fluxly/Fluxamasynth-Designs/_FluxamasynthFeather/FLUXAMASYNTHFeatherSilk.pdf

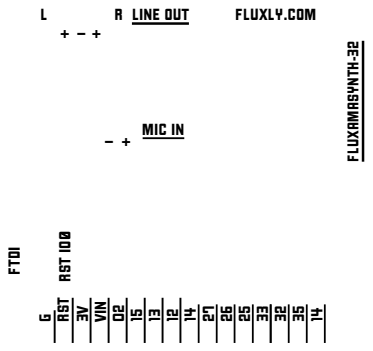
[picture p1: figure]
RST; VIN; RST IO0; FTDI; – + MIC IN; LINE OUTRL; FLUXAMASYNTH-32; FLUXLY.COM
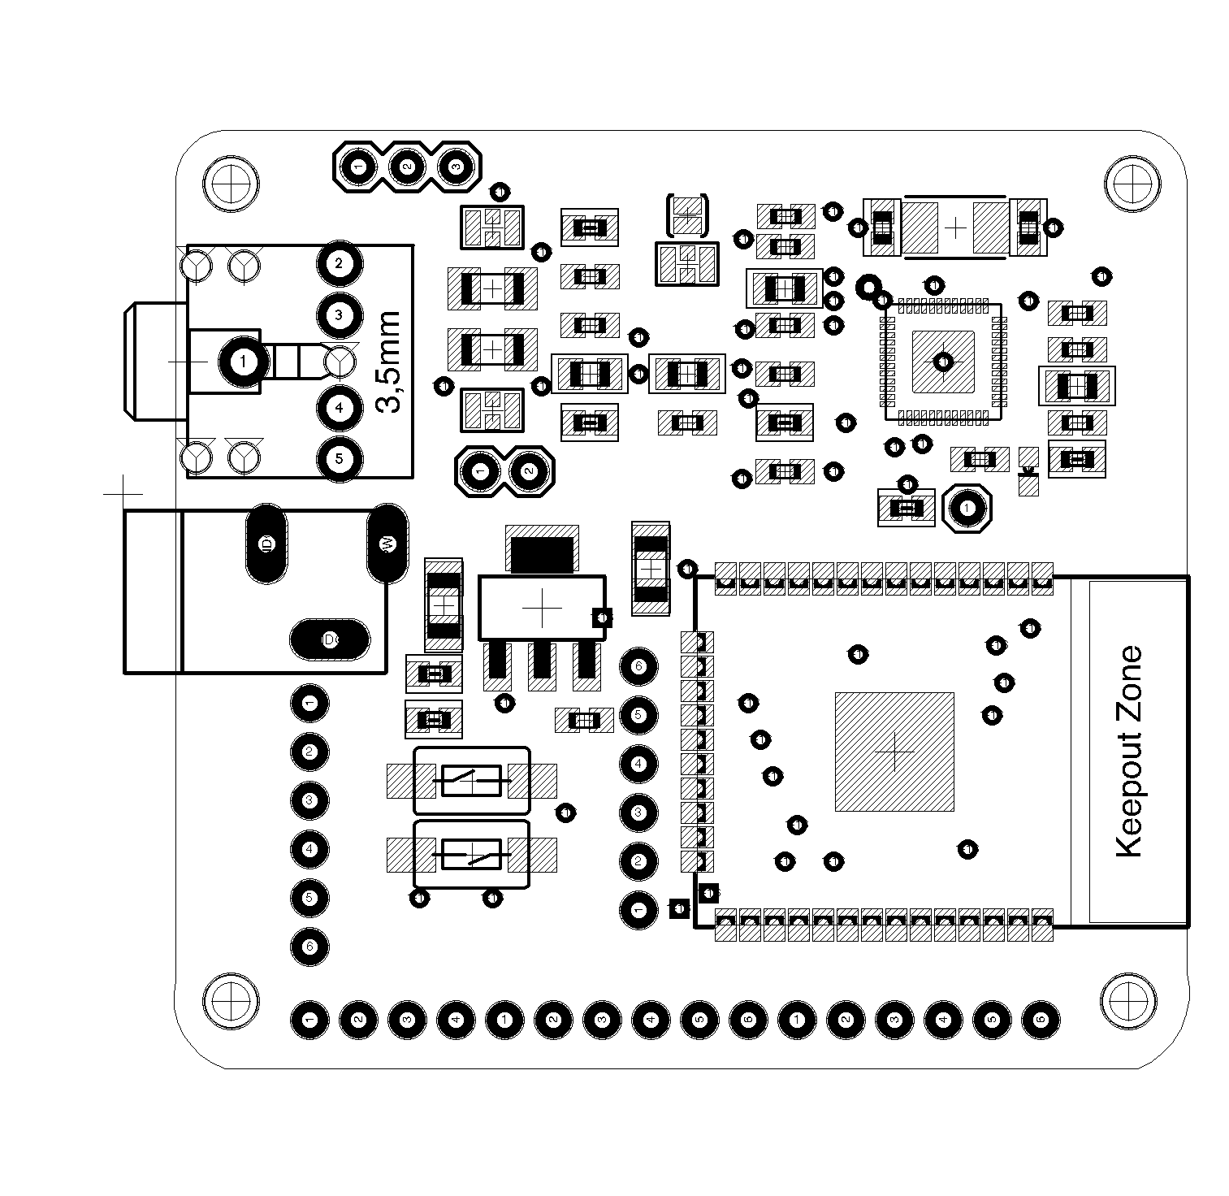
[picture p2: figure]
