fluxly/Fluxamasynth-Designs/_Fluxamasynth32/Artwork/FLUXYNTHbOTTOMsILK.bmp

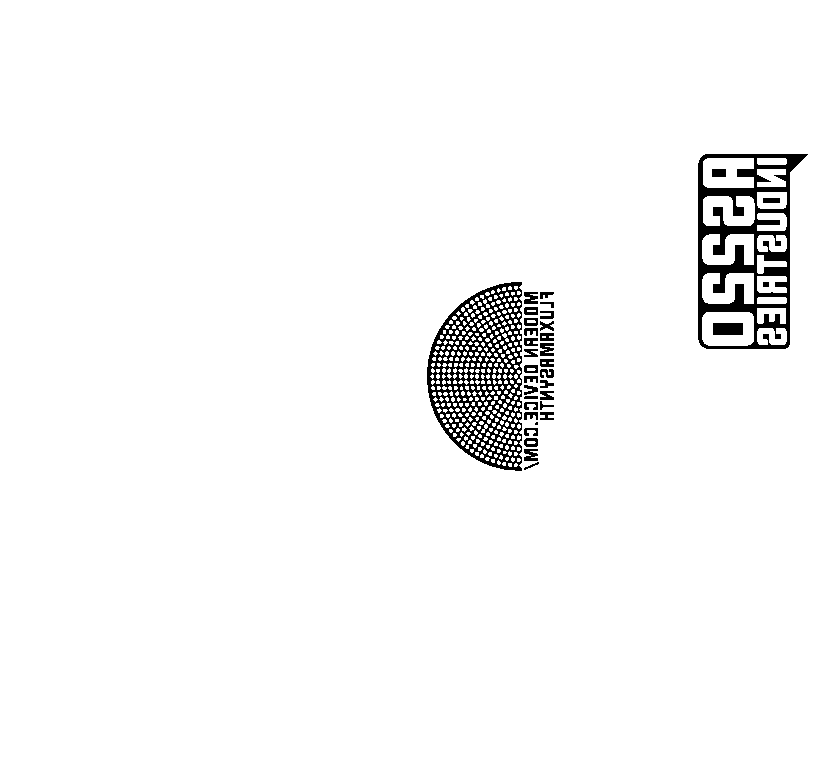
_Fluxamasynth32/Artwork/FLUXYNTHbOTTOMsILK.bmp
