fluxly/Fluxamasynth-Designs/_Fluxamasynth32/Artwork/fs32Stencil.png

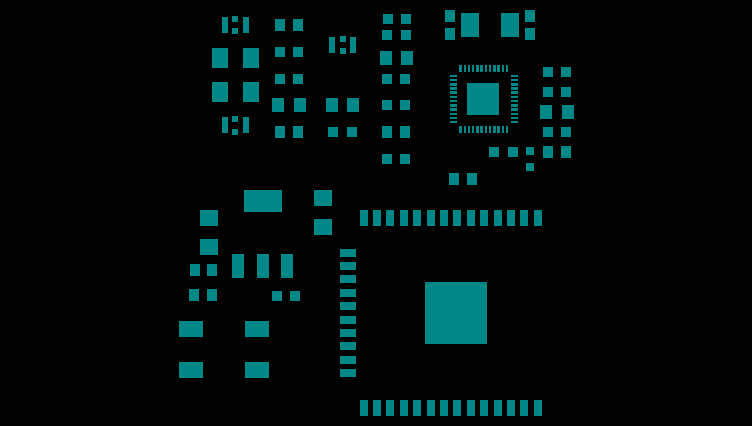
_Fluxamasynth32/Artwork/fs32Stencil.png
