fluxly/Fluxamasynth-Designs/_Fluxamasynth32/bottom.png

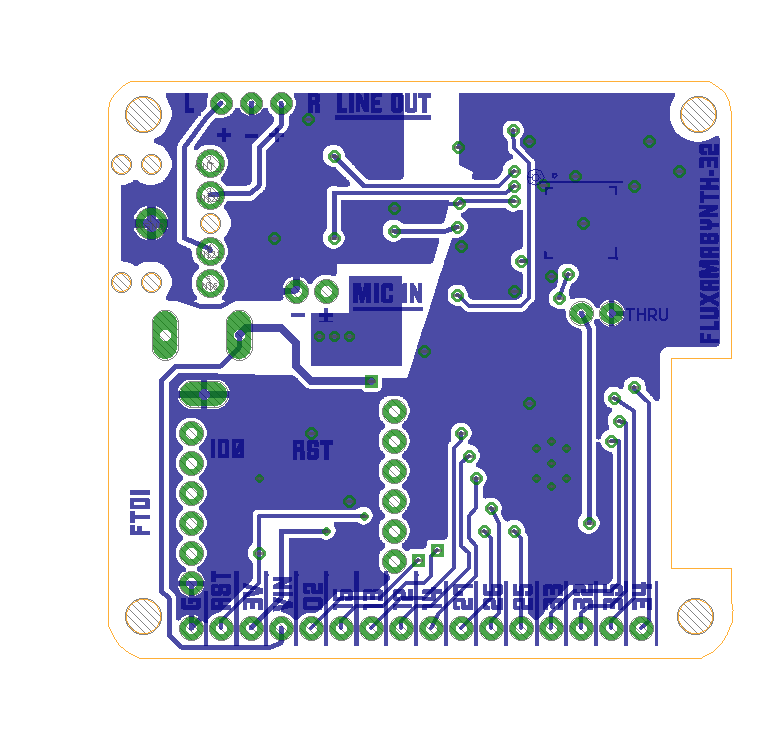
_Fluxamasynth32/bottom.png
