fluxly/Fluxamasynth-Designs/_FluxamasynthFeather/Artwork/fsFeatherStencil.png

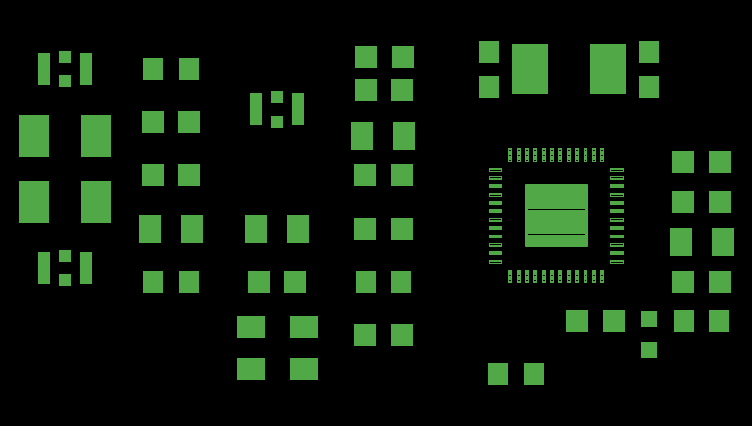
_FluxamasynthFeather/Artwork/fsFeatherStencil.png
