fluxly/Fluxamasynth-Designs/_FluxamasynthFeather/FSFeatherLayout.png

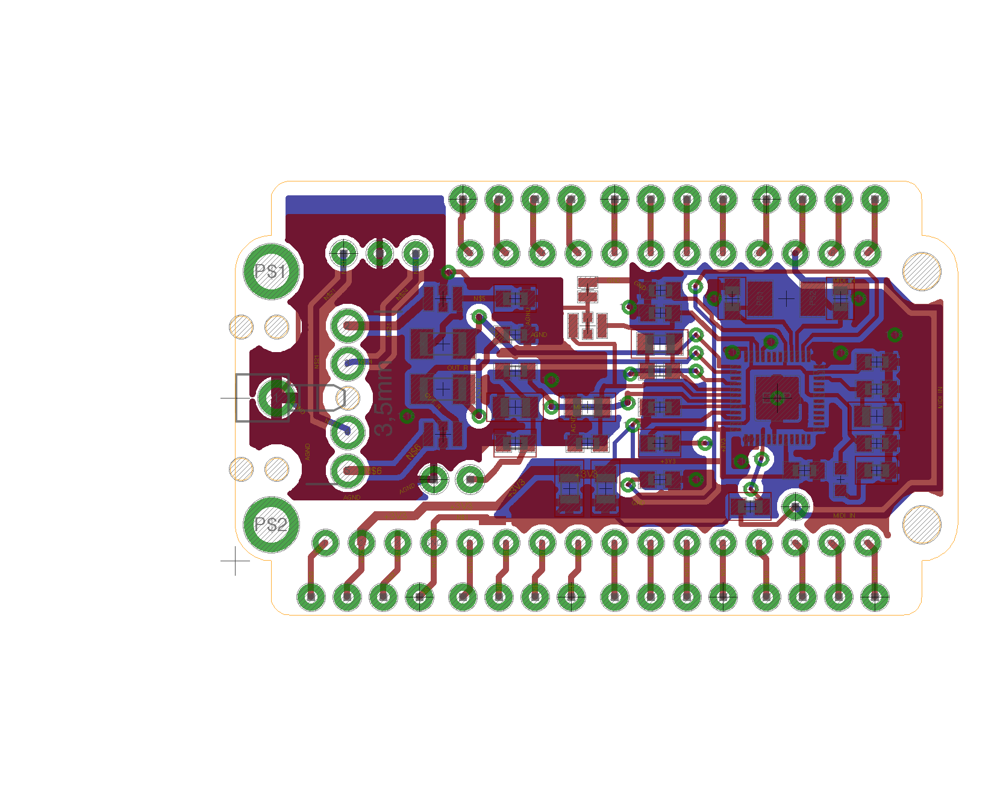
_FluxamasynthFeather/FSFeatherLayout.png
