fluxly/Fluxamasynth-Designs/_FluxamasynthFeather/fsSilk.bmp

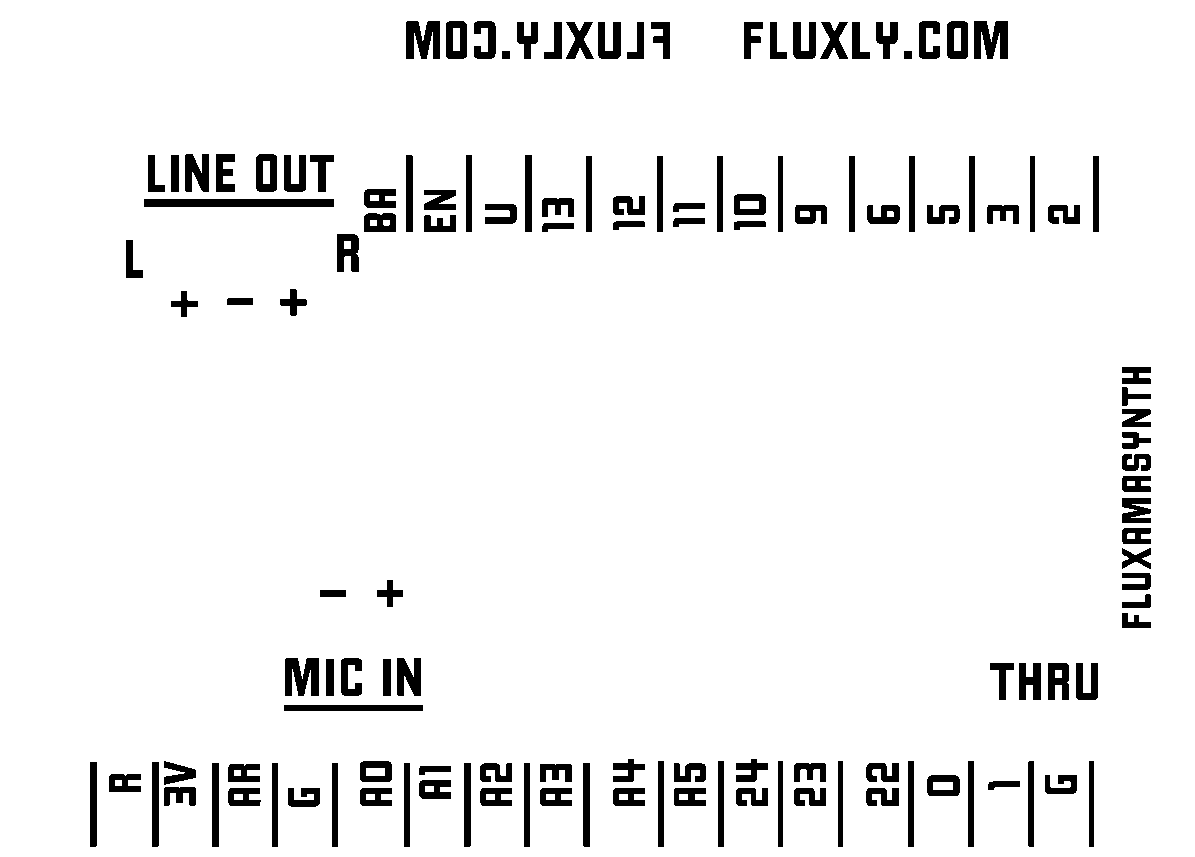
_FluxamasynthFeather/fsSilk.bmp
