fluxly/Fluxamasynth-Designs/_FluxamasynthPi/Artwork/FluxPi.png

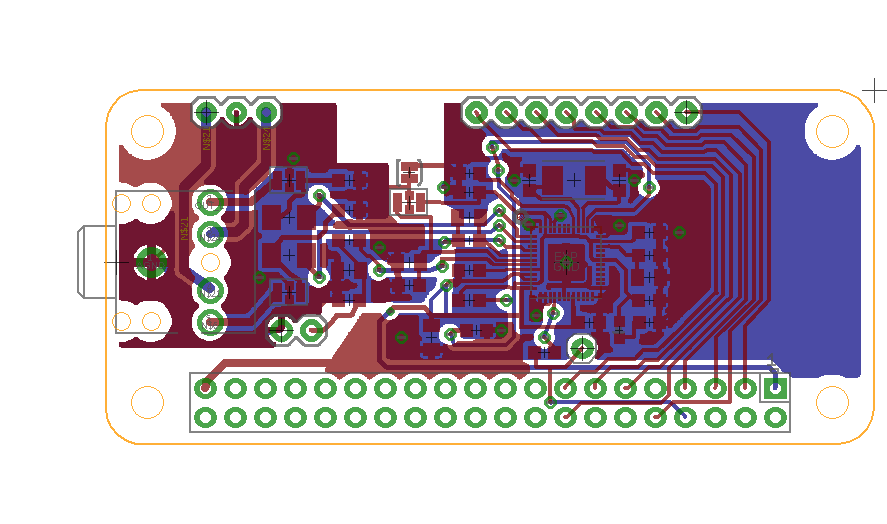
_FluxamasynthPi/Artwork/FluxPi.png
