fluxly/Fluxamasynth-Designs/_FluxamasynthPi/Artwork/FluxPiSilk.bmp

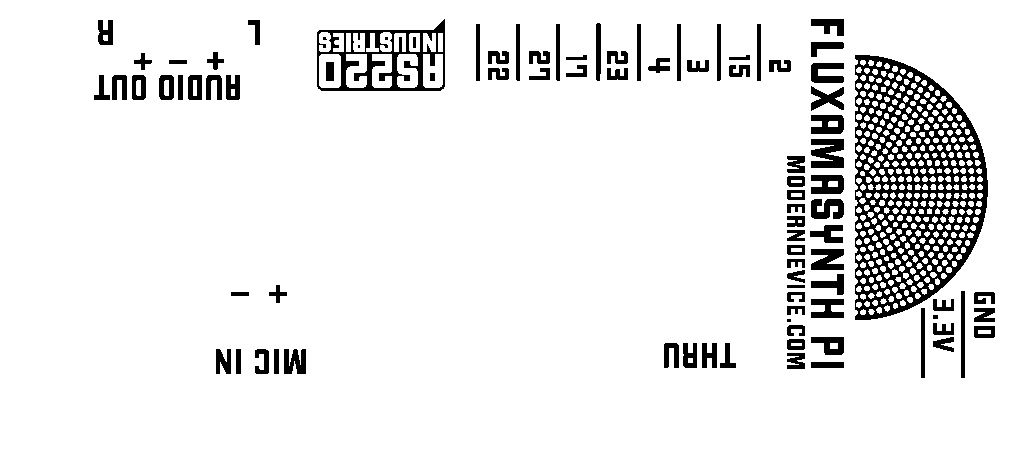
_FluxamasynthPi/Artwork/FluxPiSilk.bmp
