fluxly/Fluxamasynth-Designs/FluxamasynthFeatherBOM.xls_1.ods

Fluxamasynth For Adafruit Feather
Component | No Req | Value | Description | Package | Supplier | PartNumber | Price ea per 100 | Total cost | Notes:
C1, C3, C7, C11, C13, C18, | 6 | 10uf | cap | SMT 0805 | DigiKey | 478-3648-1-ND | $0.13 | $0.07
C4, C5, C6, C8, C12, C14, C19, C20, C21 | 5 | .1uF | cap | SMT 0603 | DigiKey | 445-1316-2-ND | $0.03 | $0.15
C16 | 1 | 1uF | cap | SMT 0603 | DigiKey | 490-1731-1-ND | $0.05 | $0.05
C9, C10 | 2 | 22pf | cap | SMT 0603 | DigiKey | 445-1273-2-n | $0.07 | $0.13
C15 | 1 | 220pf | cap | SMT 0805 | Digikey |  | $0.02 | $0.02
PC1, PC2 | 2 | 100uF | cap | SMT 1206 | Chip One Stop |  | $0.39 | $0.78
L3, L4, L5 | 3 | Filter LC HI FQ | filter cap |  | DigiKey | 490-6978-2-nd | $0.12 | $0.36
Y1 | 1 | 12MHz | crystal | TXC-7A | DigiKey | 535-9116-1-nd | $0.84 | $0.84
R5 | 1 | 220 ohm | res | SMT 0603 | DigiKey | P220ACT-ND | $0.01 | $0.01
R4 | 1 | 4.7K | res | SMT 0603 | DigiKey | 541-4.7KACT-ND | $0.02 | $0.02
R6, R8 | 2 | 47K | res | SMT 0603 | Digikey |  | $0.02 | $0.05
R7 | 1 | 100K | res | SMT 0603 | Digikey |  | $0.02 | $0.02
R1 | 1 | 470 | res | SMT 0603 | DigiKey | 541-470ACT-ND | $0.02 | $0.02
IC2 | 1 | ATSAM2695 | synth chip | QFN48 | Arrow | ATSAM2195 | $4.10 | $4.10
D2 | 1 | pink | led | 805 | DigiKey |  | $0.10 | $0.10
jack | 1 | stereojack | stereojack | stx3100 | DigiKey | CP1-3525NG-PI | $0.35 | $0.35
1x12 header | 1 | female |  |  | 4UCON |  | $0.12 | $0.12
1x16 headers | 1 | female |  |  | 4UCON |  | $0.16 | $0.16
PCB | 1 |  |  |  | PCBCart |  | $1.50 | $1.50
 |  |  |  |  |  |  |  |  | 8.84912
Assembly Labor | 1 |  |  |  |  |  | $2.00 | $2.00
Packaging | 1 |  |  |  |  |  | $0.25 | $0.25
Shipping | 1 |  |  |  |  |  | $0.10 | $0.88
Errors | 1 |  |  |  |  |  | $0.05 | $0.44
Total cost ea |  |  |  |  |  |  |  | $12.43
Wholesale |  |  |  |  |  |  |  | $20.71
Retail |  |  |  |  |  |  |  | $29.59
ESP32 Variation
ESP32 | 1 | WROOM32 |  |  | Mouser | 356-ESP-WROOM-32 (https://www.mouser.com/ProductDetail/Espressif-Systems/ESP32-WROOM-32) | $3.80 | $3.80
 | 2 | switch |  |  | DigiKey |  | $0.07 | $0.13
R, R | 2 | 10k |  |  |  |  | $0.01 | $0.02
C, C | 2 | 22uf | cap | SMT 0805 | Digikey |  | $0.20 | $0.40
C | 1 | .1uF |  |  |  |  | $0.03 | $0.03
VREG | 1 |  | cap | SMT 1206 | Mouser | 863-NCV1117ST33T3G | $0.45 | $0.45
 |  |  |  |  |  |  | Total Parts | $4.83
 |  |  |  |  |  |  | Add'l labor | $1.00
 |  |  |  |  |  |  | Total cost | $18.26
 |  |  |  |  |  |  | Wholesale | $30.43
 |  |  |  |  |  |  | Retail | $43.47
