fluxly/Fluxamasynth-Designs/Fluxamasynth Shield - MD0100 copy/Hardware/FluxamasynthShieldBOM.xls

Fluxamasynth Shield MD0101
Component | No Req | Value | Description | Package | Supplier | PartNumber | Price ea per 100 | Total cost | Notes:
C1 | 1 | 10uf | cap | SMT 0805 | DigiKey | 478-3648-1-ND | $0.08 | $0.07
C2, C5, C11 | 3 | 2.2uF | cap | SMT 0805 | DigiKey | 490-1741-1-ND | $0.07 | $0.22
C3, C4, C9, C10 | 4 | .1uF | cap | SMT 0805 | DigiKey | 445-1316-2-ND | $0.003 | $0.01
C6 | 1 | 1uF | cap | SMT 0805 | DigiKey | 490-1731-1-ND | $0.05 | $0.05
C7, C8 | 2 | 18pF | cap | SMT 0805 | DigiKey | 478-1307-1-ND | $0.07 | $0.13
C12 | 1 | 470pF | cap | SMT 0805 | DigiKey | 478-1324-1-ND | $0.02 | $0.02
D1 | 1 | DIODE Zener | diode | SOD123 | DigiKey | BZT52C3V3-FDICT-ND | $0.12 | $0.12
IC1 | 1 | 3.3V100MA LDO | VREG | SOT23 | DigiKey | LM3480IM3-3.3CT-ND | $0.44 | $0.44
Q2 | 1 | 9.6MHz | crystal | TC26H | DigiKey | SER3418-ND replace with CTX680CT-ND | $0.84 | $0.84
R1, R10, R12 | 3 | 220 ohm | res | SMT 0805 | DigiKey | P220ACT-ND | $0.01 | $0.03
R2, R7 | 2 | 10 ohm | res | SMT 0805 | DigiKey | P10ACT-ND | $0.01 | $0.02
R3, R13 | 2 | 3.3k | res | SMT 0805 | DigiKey | 541-3.3KACT-ND | $0.02 | $0.05
R4 | 1 | 1k | res | SMT 0805 | DigiKey | 541-1.0KACT-ND | $0.02 | $0.02
R6 | 1 | o ohm | res | SMT 0805 | DigiKey | 541-0.0ACT-ND | $0.02 | $0.02
S1 | 1 | switch | 6mm switch | 6mm | DigiKey | SW262CT-ND | $0.06 | $0.06
IC2 | 1 | ATSAM2195 | synth chip | QFN | Arrow | ATSAM2195 | $5.20 | $5.20
D2 | 1 | red | led | 1206 | DigiKey | 160-1167-1-ND | $0.10 | $0.10
jack | 1 | stereojack | stereojack | stx3100 | DigiKey | CP1-3525NG-ND | $0.35 | $0.35
1x6 headers | 2 | female | double length | 1x6 headers | 4UCON | 18688 | $0.08 | $0.15
1x8 headers | 2 | female | double length | 1x8 headers | 4UCON | 18689 | $0.09 | $0.18
1x3 headers | 1 | male | 1x3 headers | 1x3 headers | 4UCON | 798 | $0.02 | $0.02
jumper | 1 | jumper | jumper | jumper | 4UCON | 5729 | $0.03 | $0.03
PCB | 1 |  |  |  | PCBCart |  | $1.50 | $1.50
Assembly Labor | 1 |  |  |  |  |  | $4.00 | $4.00
Packaging | 1 |  |  |  |  |  | $0.25 | $0.25
Shipping | 1 |  |  |  |  |  | $0.10 | $0.96
Errors | 1 |  |  |  |  |  | $0.05 | $0.48
Total cost ea |  |  |  |  |  |  |  | $15.33
Wholesale |  |  |  |  |  |  |  | $25.54
Retail |  |  |  |  |  |  |  | $42.57
 |  |  |  |  |  |  | GOAL | $39.95
