fluxly/Fluxamasynth-Designs/Fluxamasynth_III/FluxR3-v3.brd

## EAGLE design Fluxamasynth_III/FluxR3-v3.brd (2018-05-23)

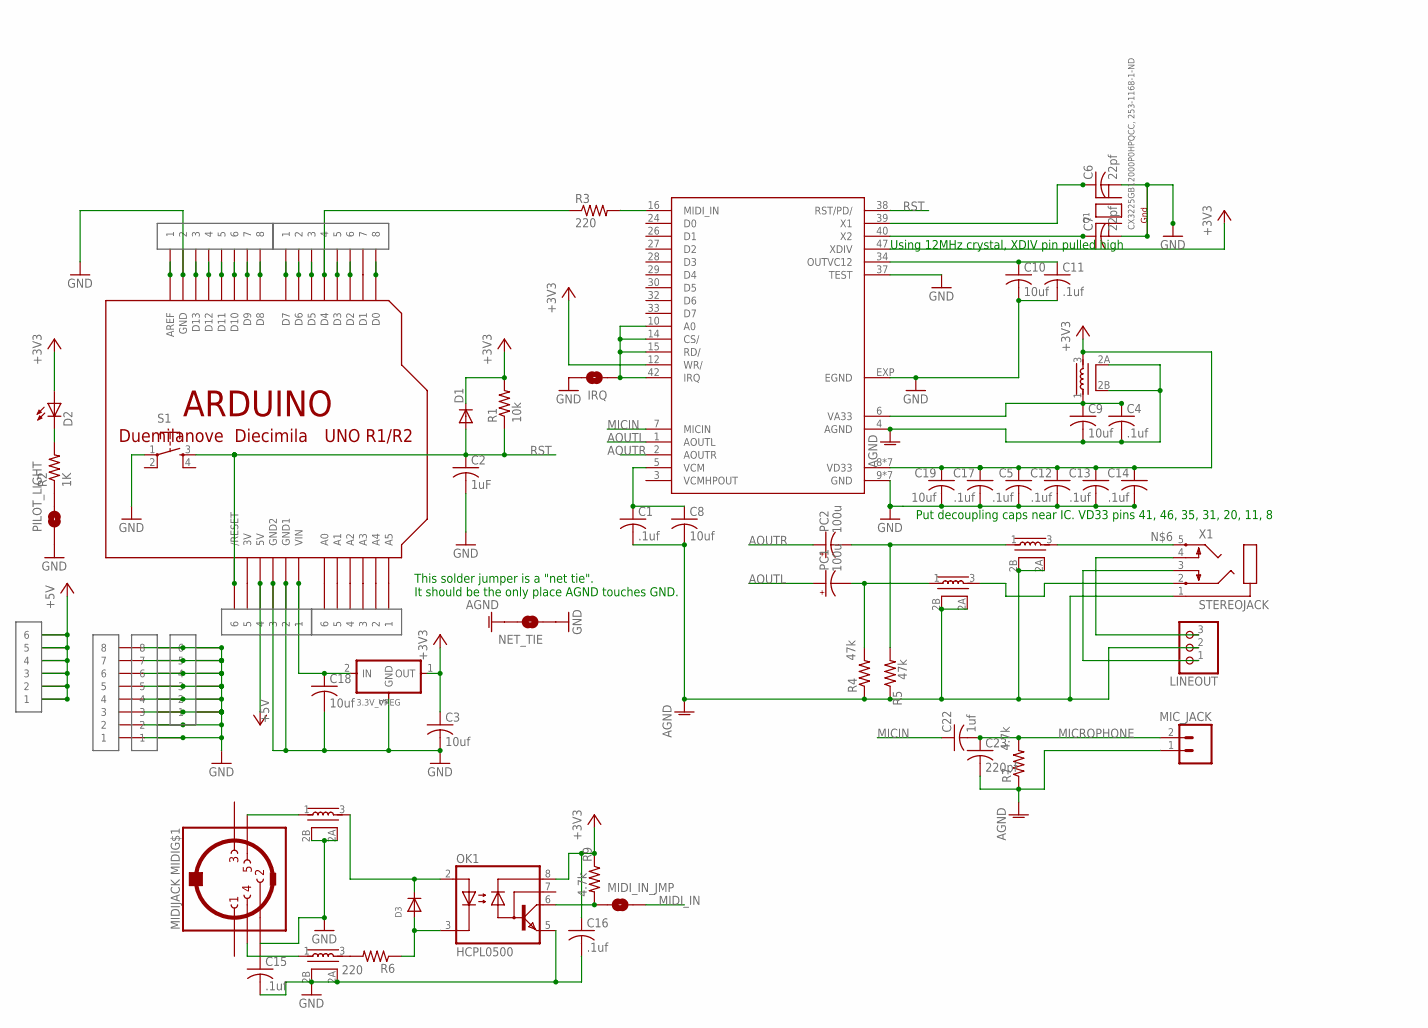
[picture p11: schematic FluxR3-v3.sch]

Parts:
3.3V_VREG: REGULATORSOT23; SOT23
ARDUINO: ARDUINO-NOHOLE
C1, C4, C5, C11, C12, C13, C14, C17: .1uf; C0603K
C2: 1uF; C0805
C3, C8, C9, C10, C18, C19: 10uf; C0805
C6, C7: 22pf; C0805
C15, C16: .1uf; C0805
C22: 1uf; C0805
C23: 220pf; C0805
D1: DIODESOD123; SOD123
D2: LED1206; LED-1206
D3: DIODE_SOD-523; SOD-523
IRQ: MODERNDEVICE_SOLDERJUMPERTRACE; MODERNDEVICE_SJ_2S-TRACE
LINEOUT: PINHD-1X3; 1X03
MIC_JACK: M02PTH; 1X02
MIDI: MIDIJACK; CP-2350
MIDI_IN_JMP: SOLDERJUMPERNO; SJ_2S-NO
NET_TIE: MODERNDEVICE_SOLDERJUMPERTRACE; MODERNDEVICE_SJ_2S-TRACE
OK1: HCPL0500; SOIC08
PC1, PC2: 100u; PANASONIC_E
PILOT_LIGHT: MODERNDEVICE_SOLDERJUMPERTRACE; MODERNDEVICE_SJ_2S-TRACE
Q1: CX3225GB12000P0HPQCC, 253-1168-1-ND; MODERNDEVICE_NX3225
R1: 10k; M0805
R2: 1K; M0805
R3, R6: 220; M0805
R4, R5: 47k; R0603
R7: 4.7k; M0805
R9: 4.7k; R0603
S1: 6MM_SWITCH6MM_SWITCH; 6MM_SWITCH
SAM2695: SAM2695; QFN48
U$1, U$9, U$11, U$13: 1X8_CLEAN
U$2, U$3, U$6, U$8: 1X6_CLEAN
U$4, U$5, U$7, U$10, U$12: NFM21CC223R1H3D; 3PC
X1: STEREOJACK; STX3100

Connections:
+3V3: 3.3V_VREG.1 (OUT), C3.1, C5.1, C12.1, C13.1, C14.1, C16.1, C17.1, C19.1, D1.CATHODE (C), D2.A, OK1.8 (VCC), R1.2, R9.1, SAM2695.8 (VD33), SAM2695.11 (VD33), SAM2695.12 (WR/), SAM2695.20 (VD33), SAM2695.31 (VD33), SAM2695.35 (VD33), SAM2695.41 (VD33), SAM2695.46 (VD33), SAM2695.47 (XDIV), U$7.3
+5V: ARDUINO.5V, U$2.P$1 (1), U$2.P$2 (2), U$2.P$3 (3), U$2.P$4 (4), U$2.P$5 (5), U$2.P$6 (6), U$6.P$4 (4)
A0: ARDUINO.A0, U$8.P$6 (6)
A1: ARDUINO.A1, U$8.P$5 (5)
A2: ARDUINO.A2, U$8.P$4 (4)
A3: ARDUINO.A3, U$8.P$3 (3)
A4: ARDUINO.A4, U$8.P$2 (2)
A5: ARDUINO.A5, U$8.P$1 (1)
AGND: C1.2, C4.2, C8.2, C9.2, C23.2, LINEOUT.2, MIC_JACK.1, NET_TIE.2, R4.1, R5.1, R7.1, SAM2695.4 (AGND), U$4.2A, U$4.2B, U$5.2A, U$5.2B, U$7.2A, U$7.2B, X1.1
AOUTL: PC1.+, SAM2695.1 (AOUTL)
AOUTR: PC2.+, SAM2695.2 (AOUTR)
GND: 3.3V_VREG.3 (GND), ARDUINO.GND, ARDUINO.GND1, ARDUINO.GND2, C2.2, C3.2, C5.2, C6.2, C7.2, C10.2, C11.2, C12.2, C13.2, C14.2, C15.2, C16.2, C17.2, C18.2, C19.2, IRQ.2, NET_TIE.1, OK1.5 (GND), PILOT_LIGHT.1, Q1.2 (G2), Q1.4 (G1), S1.1, SAM2695.9 (GND), SAM2695.13 (GND), SAM2695.18 (GND), SAM2695.25 (GND), SAM2695.36 (GND), SAM2695.37 (TEST), SAM2695.45 (GND), SAM2695.48 (GND), SAM2695.EXP (EGND), U$1.P$1 (1), U$1.P$2 (2), U$1.P$3 (3), U$1.P$4 (4), U$1.P$5 (5), U$1.P$6 (6), U$1.P$7 (7), U$1.P$8 (8), U$3.P$1 (1), U$3.P$2 (2), U$3.P$3 (3), U$3.P$4 (4), U$3.P$5 (5), U$3.P$6 (6), U$6.P$2 (2), U$6.P$3 (3), U$10.2A, U$10.2B, U$11.P$1 (1), U$11.P$2 (2), U$11.P$3 (3), U$11.P$4 (4), U$11.P$5 (5), U$11.P$6 (6), U$11.P$7 (7), U$11.P$8 (8), U$12.2A, U$12.2B, U$13.P$2 (2)
MICIN: C22.1, SAM2695.7 (MICIN)
MICROPHONE: C22.2, C23.1, MIC_JACK.2, R7.2
MIDI_FROM_ARDUINO: ARDUINO.D4, MIDI_IN_JMP.1, OK1.6 (VO), R3.1, R9.2, U$9.P$4 (4)
MIDI_IN: MIDI_IN_JMP.2, R3.2, SAM2695.16 (MIDI_IN)
unnamed: ARDUINO.D1, U$9.P$7 (7)
unnamed: MIDI.4, U$10.1
unnamed: IRQ.1, SAM2695.10 (A0), SAM2695.14 (CS/), SAM2695.15 (RD/), SAM2695.42 (IRQ)
unnamed: ARDUINO.3V, U$6.P$5 (5)
unnamed: PC1.-, R4.2, U$5.1
unnamed: U$4.3, X1.5
unnamed: R6.2, U$10.3
unnamed: D3.K (C), OK1.2 (A), U$12.3
unnamed: D2.C, R2.2
unnamed: C15.1, MIDI.2
unnamed: MIDI.5, U$12.1
unnamed: D3.A, OK1.3 (C), R6.1
unnamed: ARDUINO.D8, U$13.P$8 (8)
unnamed: ARDUINO.D9, U$13.P$7 (7)
unnamed: LINEOUT.3, X1.4
unnamed: ARDUINO.D11, U$13.P$5 (5)
unnamed: ARDUINO.D10, U$13.P$6 (6)
unnamed: LINEOUT.1, X1.3
unnamed: ARDUINO.D12, U$13.P$4 (4)
unnamed: ARDUINO.D13, U$13.P$3 (3)
unnamed: ARDUINO.D6, U$9.P$2 (2)
unnamed: ARDUINO.AREF, U$13.P$1 (1)
unnamed: ARDUINO.D5, U$9.P$3 (3)
unnamed: ARDUINO.D0, U$9.P$8 (8)
unnamed: ARDUINO.D2, U$9.P$6 (6)
unnamed: ARDUINO.D3, U$9.P$5 (5)
unnamed: ARDUINO.D7, U$9.P$1 (1)
unnamed: PILOT_LIGHT.2, R2.1
unnamed: C6.1, SAM2695.39 (X1)
unnamed: C7.1, SAM2695.40 (X2)
OUTVC12: C10.1, C11.1, SAM2695.34 (OUTVC12)
OUT_L: U$5.3, X1.2
OUT_R: PC2.-, R5.2, U$4.1
RST: ARDUINO.RESET (/RESET), C2.1, D1.ANODE (A), R1.1, S1.3 (S), SAM2695.38 (RST/PD/), U$6.P$6 (6)
VA33: C4.1, C9.1, SAM2695.6 (VA33), U$7.1
VCM: C1.1, C8.1, SAM2695.5 (VCM)
VIN: 3.3V_VREG.2 (IN), ARDUINO.VIN, C18.1, U$6.P$1 (1)

Notes on the sheet:
Using 12MHz crystal, XDIV pin pulled high
Put decoupling caps near IC. VD33 pins 41, 46, 35, 31, 20, 11, 8
This solder jumper is a "net tie". It should be the only place AGND touches GND.

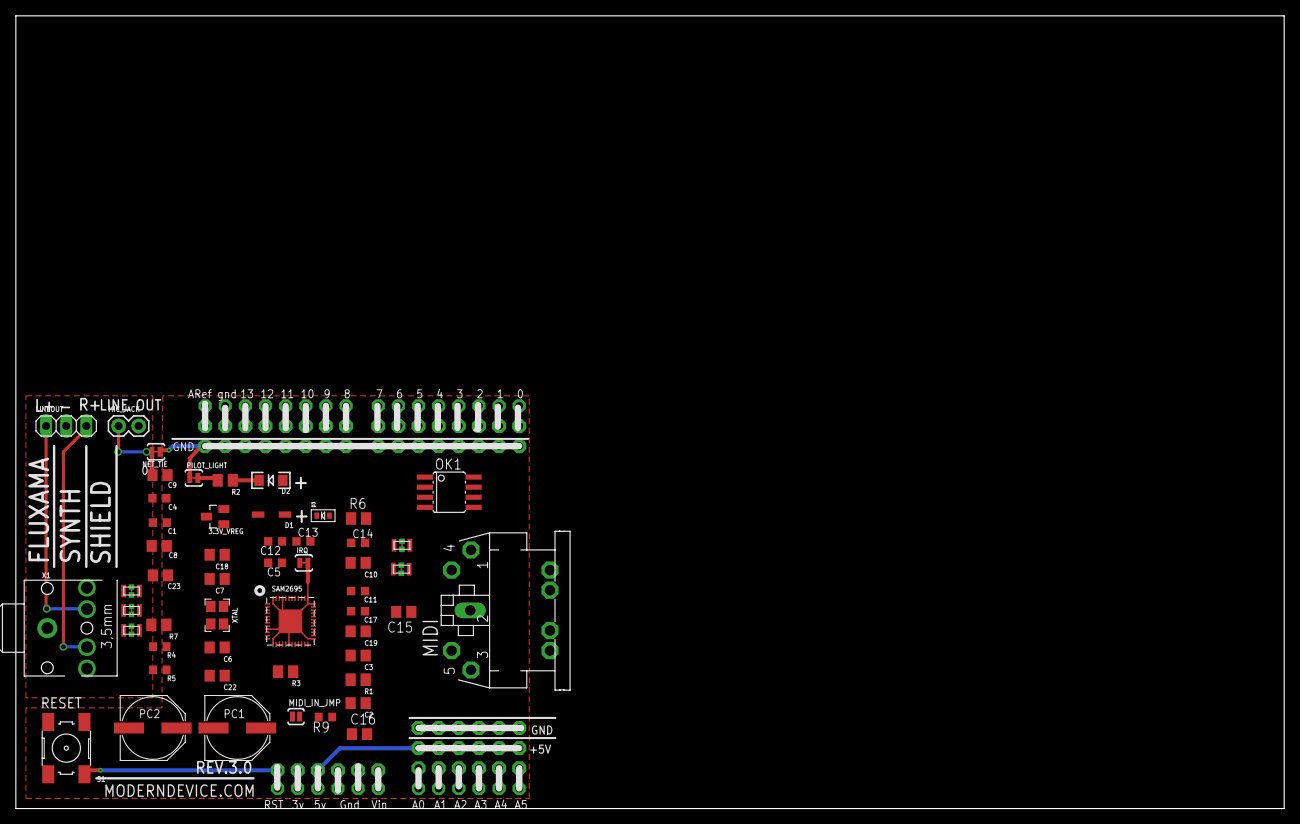
[picture p12: board FluxR3-v3.brd from above]

Board: 2 copper layers, 160.0 x 100.0 mm, 61 parts (0 on the bottom side), 53 nets.
