fluxly/Fluxamasynth-Designs/Fluxamasynth_III/FluxR3-v1.brd

## EAGLE design Fluxamasynth_III/FluxR3-v1.brd (2018-05-23, an earlier design)

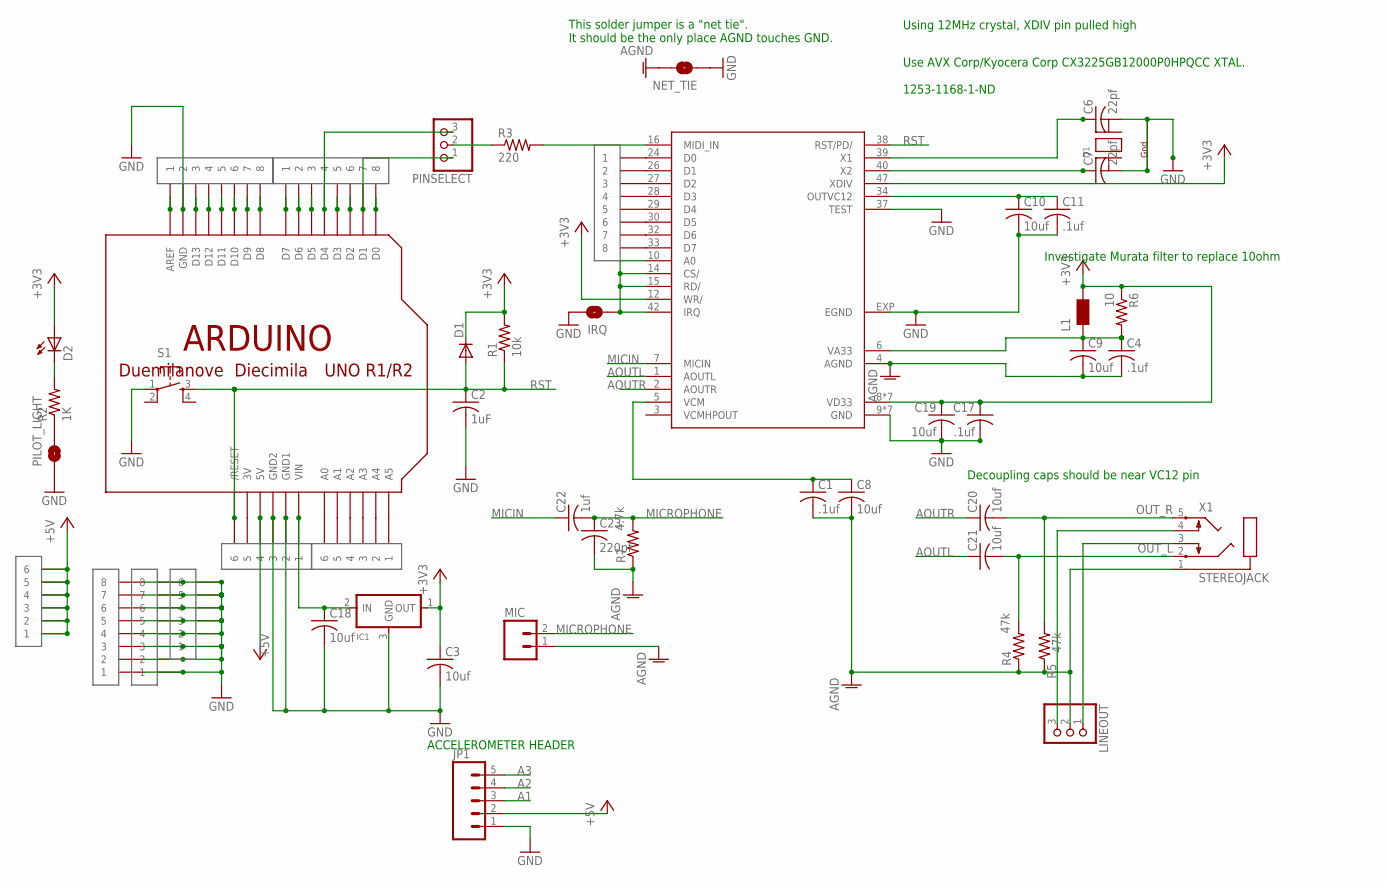
[picture p13: schematic FluxR3-v1.sch]

Parts:
C1, C4, C11, C17: .1uf; C0603K
C2: 1uF; C0805
C3, C8, C9, C10, C18, C19, C20, C21: 10uf; C0805
C6, C7: 22pf; C0805
C22: 1uf; C0805
C23: 220pf; C0805
D1: DIODESOD123; SOD123
D2: LED1206; LED-1206
IC1: REGULATORSOT23; SOT23
IRQ: MODERNDEVICE_SOLDERJUMPERTRACE; MODERNDEVICE_SJ_2S-TRACE
JP1: M05NOSILK; 1X05_NOSILK
L1: FERRITE_BEAD_L0603; R0603
LINEOUT: PINHD-1X3; 1X03
MIC: M02PTH; 1X02
MIDI: 1X8_CLEAN
NET_TIE: MODERNDEVICE_SOLDERJUMPERTRACE; MODERNDEVICE_SJ_2S-TRACE
PILOT_LIGHT: MODERNDEVICE_SOLDERJUMPERTRACE; MODERNDEVICE_SJ_2S-TRACE
PINSELECT: PINHD-1X3; 1X03
Q1: MODERNDEVICE_XTAL-4-3225; MODERNDEVICE_NX3225
R1: 10k; M0805
R2: 1K; M0805
R3: 220; M0805
R4, R5: 47k; R0603
R6: 10; M0805
R7: 4.7k; M0805
S1: 6MM_SWITCH6MM_SWITCH; 6MM_SWITCH
U1: SAM2695; QFN48
U$1, U$9, U$11, U$13: 1X8_CLEAN
U$2, U$3, U$6, U$8: 1X6_CLEAN
U$12: ARDUINO-NOHOLE
X1: STEREOJACK; STX3100

Connections:
+3V3: C3.1, C17.1, C19.1, D1.CATHODE (C), D2.A, IC1.1 (OUT), L1.2, R1.2, R6.1, U1.8 (VD33), U1.11 (VD33), U1.12 (WR/), U1.20 (VD33), U1.31 (VD33), U1.35 (VD33), U1.41 (VD33), U1.46 (VD33), U1.47 (XDIV)
+5V: JP1.2, U$2.P$1 (1), U$2.P$2 (2), U$2.P$3 (3), U$2.P$4 (4), U$2.P$5 (5), U$2.P$6 (6), U$6.P$4 (4), U$12.5V
A0: U$8.P$6 (6), U$12.A0
A1: JP1.3, U$8.P$5 (5), U$12.A1
A2: JP1.4, U$8.P$4 (4), U$12.A2
A3: JP1.5, U$8.P$3 (3), U$12.A3
A4: U$8.P$2 (2), U$12.A4
A5: U$8.P$1 (1), U$12.A5
AGND: C1.2, C4.2, C8.2, C9.2, C23.2, LINEOUT.2, MIC.1, NET_TIE.2, R4.1, R5.1, R7.1, U1.4 (AGND), X1.1
AOUTL: C21.1, U1.1 (AOUTL)
AOUTR: C20.1, U1.2 (AOUTR)
GND: C2.2, C3.2, C6.2, C7.2, C10.2, C11.2, C17.2, C18.2, C19.2, IC1.3 (GND), IRQ.2, JP1.1, NET_TIE.1, PILOT_LIGHT.1, Q1.2 (G2), Q1.4 (G1), S1.1, U1.9 (GND), U1.13 (GND), U1.18 (GND), U1.25 (GND), U1.36 (GND), U1.37 (TEST), U1.45 (GND), U1.48 (GND), U1.EXP (EGND), U$1.P$1 (1), U$1.P$2 (2), U$1.P$3 (3), U$1.P$4 (4), U$1.P$5 (5), U$1.P$6 (6), U$1.P$7 (7), U$1.P$8 (8), U$3.P$1 (1), U$3.P$2 (2), U$3.P$3 (3), U$3.P$4 (4), U$3.P$5 (5), U$3.P$6 (6), U$6.P$2 (2), U$6.P$3 (3), U$11.P$1 (1), U$11.P$2 (2), U$11.P$3 (3), U$11.P$4 (4), U$11.P$5 (5), U$11.P$6 (6), U$11.P$7 (7), U$11.P$8 (8), U$12.GND, U$12.GND1, U$12.GND2, U$13.P$2 (2)
MICIN: C22.1, U1.7 (MICIN)
MICROPHONE: C22.2, C23.1, MIC.2, R7.2
unnamed: PINSELECT.2, R3.1
unnamed: R3.2, U1.16 (MIDI_IN)
unnamed: IRQ.1, U1.10 (A0), U1.14 (CS/), U1.15 (RD/), U1.42 (IRQ)
unnamed: U$6.P$5 (5), U$12.3V
unnamed: MIDI.P$1 (1), U1.24 (D0)
unnamed: MIDI.P$2 (2), U1.26 (D1)
unnamed: MIDI.P$3 (3), U1.27 (D2)
unnamed: MIDI.P$4 (4), U1.28 (D3)
unnamed: D2.C, R2.2
unnamed: MIDI.P$5 (5), U1.29 (D4)
unnamed: MIDI.P$6 (6), U1.30 (D5)
unnamed: C1.1, C8.1, U1.5 (VCM)
unnamed: MIDI.P$7 (7), U1.32 (D6)
unnamed: MIDI.P$8 (8), U1.33 (D7)
unnamed: U$12.D8, U$13.P$8 (8)
unnamed: PINSELECT.1, U$9.P$7 (7), U$12.D1
unnamed: PINSELECT.3, U$9.P$4 (4), U$12.D4
unnamed: U$12.D9, U$13.P$7 (7)
unnamed: LINEOUT.3, X1.4
unnamed: U$12.D11, U$13.P$5 (5)
unnamed: U$12.D10, U$13.P$6 (6)
unnamed: LINEOUT.1, X1.3
unnamed: U$12.D12, U$13.P$4 (4)
unnamed: U$12.D13, U$13.P$3 (3)
unnamed: U$9.P$2 (2), U$12.D6
unnamed: U$12.AREF, U$13.P$1 (1)
unnamed: U$9.P$3 (3), U$12.D5
unnamed: U$9.P$8 (8), U$12.D0
unnamed: U$9.P$6 (6), U$12.D2
unnamed: U$9.P$5 (5), U$12.D3
unnamed: U$9.P$1 (1), U$12.D7
unnamed: C4.1, C9.1, L1.1, R6.2, U1.6 (VA33)
unnamed: PILOT_LIGHT.2, R2.1
unnamed: C6.1, U1.39 (X1)
unnamed: C7.1, U1.40 (X2)
OUTVC12: C10.1, C11.1, U1.34 (OUTVC12)
OUT_L: C21.2, R4.2, X1.2
OUT_R: C20.2, R5.2, X1.5
RST: C2.1, D1.ANODE (A), R1.1, S1.3 (S), U1.38 (RST/PD/), U$6.P$6 (6), U$12.RESET (/RESET)
VIN: C18.1, IC1.2 (IN), U$6.P$1 (1), U$12.VIN

Notes on the sheet:
Using 12MHz crystal, XDIV pin pulled high
Investigate Murata filter to replace 10ohm
Use AVX Corp/Kyocera Corp CX3225GB12000P0HPQCC XTAL. 1253-1168-1-ND
Decoupling caps should be near VC12 pin
This solder jumper is a "net tie". It should be the only place AGND touches GND.
ACCELEROMETER HEADER

Board: 2 copper layers, 49 parts (0 on the bottom side), 54 nets, no tracks yet.
