fluxly/Fluxamasynth-Designs/Fluxamasynth_III/FluxamasynthPhoton.brd

## EAGLE design Fluxamasynth_III/FluxamasynthPhoton.brd (2018-05-23)

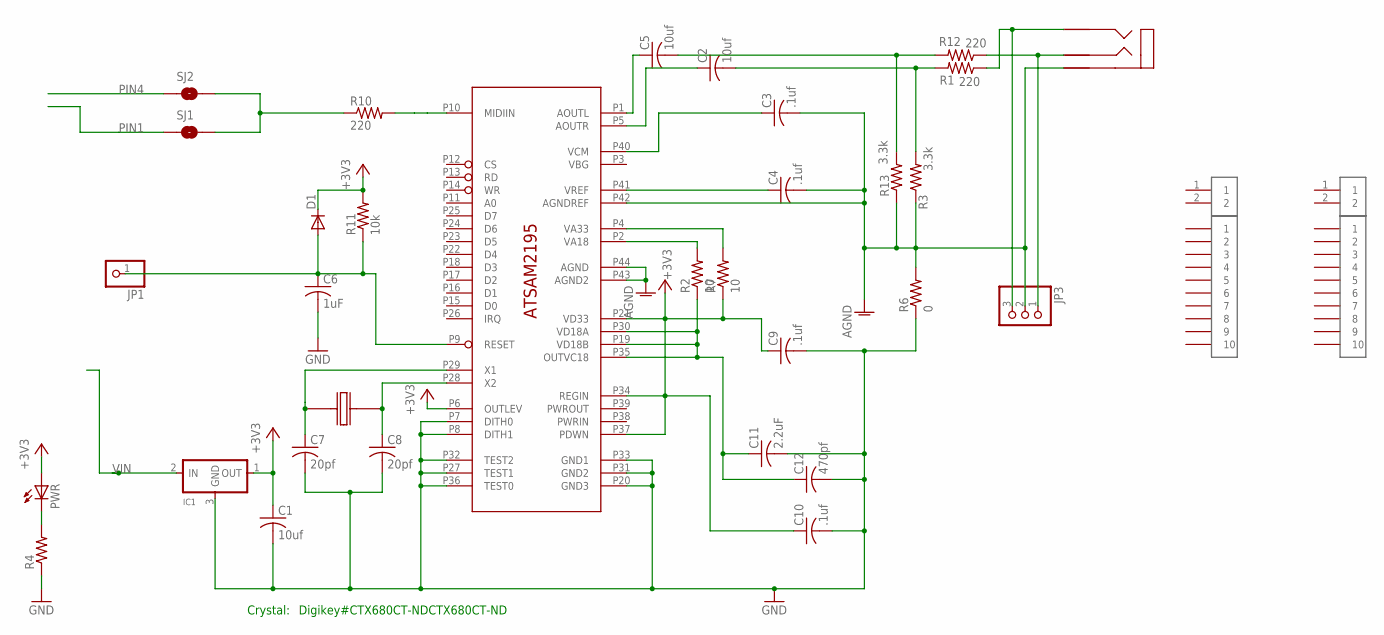
[picture p14: schematic FluxamasynthPhoton.sch]

Parts:
C1, C2, C5: 10uf; C0603
C3, C4, C9, C10: .1uf; C0603
C6: 1uF; C0603
C7, C8: 20pf; C0603K
C11: 2.2uF; C0603
C12: 470pf; C0603
D1: DIODESOD123; SOD123
IC1: REGULATORSOT23; SOT23
JP1: PINHD-1X1; 1X01
JP3: PINHD-1X3CB; 1X03-CLEANBIG
PWR: LED0603; LED-0603
R1, R10, R12: 220; R0603
R2, R7: 10; R0603
R3, R13: 3.3k; R0603
R4: R-US_R0603; R0603
R6: 0; R0603
R11: 10k; R0603
SJ1: SOLDERJUMPERNO; SJ_2S-NO
SJ2: SOLDERJUMPERNC2; SJ_2S-NOTRACE
U$1: ATSAM2195
U$2: CRYSTAL_7X5
U$3, U$5: 1X10_CLEAN
U$4: STEREO_AUDIO_JACK_SMT
U$6, U$7: 1X2_CLEAN

Connections:
+3V3: C1.1, C9.1, C10.1, D1.CATHODE (C), IC1.1 (OUT), PWR.A, R7.1, R11.2, U$1.P6 (OUTLEV), U$1.P21 (VD33), U$1.P34 (REGIN), U$1.P37 (PDWN)
AGND: C3.2, C4.2, JP3.2, R3.1, R6.2, R13.1, U$1.P42 (AGNDREF), U$1.P43 (AGND2), U$1.P44 (AGND), U$4.P$1 (SHIELD)
CA11: C2.1, U$1.P5 (AOUTR)
GND: C1.2, C6.2, C7.2, C8.2, C9.2, C10.2, C11.2, C12.2, IC1.3 (GND), R4.1, R6.1, U$1.P7 (DITH0), U$1.P8 (DITH1), U$1.P20 (GND3), U$1.P27 (TEST1), U$1.P31 (GND2), U$1.P32 (TEST2), U$1.P33 (GND1), U$1.P36 (TEST0)
unnamed: R10.1, SJ1.2, SJ2.2
unnamed: R10.2, U$1.P10 (MIDIIN)
unnamed: C8.1, U$1.P28 (X2), U$2.P$3
unnamed: C7.1, U$1.P29 (X1), U$2.P$1
unnamed: C11.1, C12.1, R2.1, U$1.P19 (VD18B), U$1.P30 (VD18A), U$1.P35 (OUTVC18)
unnamed: R2.2, U$1.P2 (VA18)
unnamed: C5.1, U$1.P1 (AOUTL)
unnamed: PWR.C, R4.2
unnamed: C5.2, R12.2, R13.2
unnamed: C2.2, R1.2, R3.2
unnamed: C3.1, U$1.P40 (VCM)
unnamed: R7.2, U$1.P4 (VA33)
unnamed: C6.1, D1.ANODE (A), JP1.1, R11.1, U$1.P9 (RESET)
unnamed: C4.1, U$1.P41 (VREF)
unnamed: JP3.3, R1.1, U$4.P$2 (TIP)
unnamed: JP3.1, R12.1, U$4.P$3 (RING)
PIN1: SJ1.1
PIN4: SJ2.1
VIN: IC1.2 (IN)

Notes on the sheet:
Digikey#CTX680CT-NDCTX680CT-ND
Crystal:

Board: 2 copper layers, 36 parts (1 on the bottom side), 20 nets, no tracks yet.
