fluxly/Fluxamasynth-Designs/_Fluxamasynth32/Fluxamasynth32.brd

## EAGLE design _Fluxamasynth32/Fluxamasynth32.brd (2018-05-23)

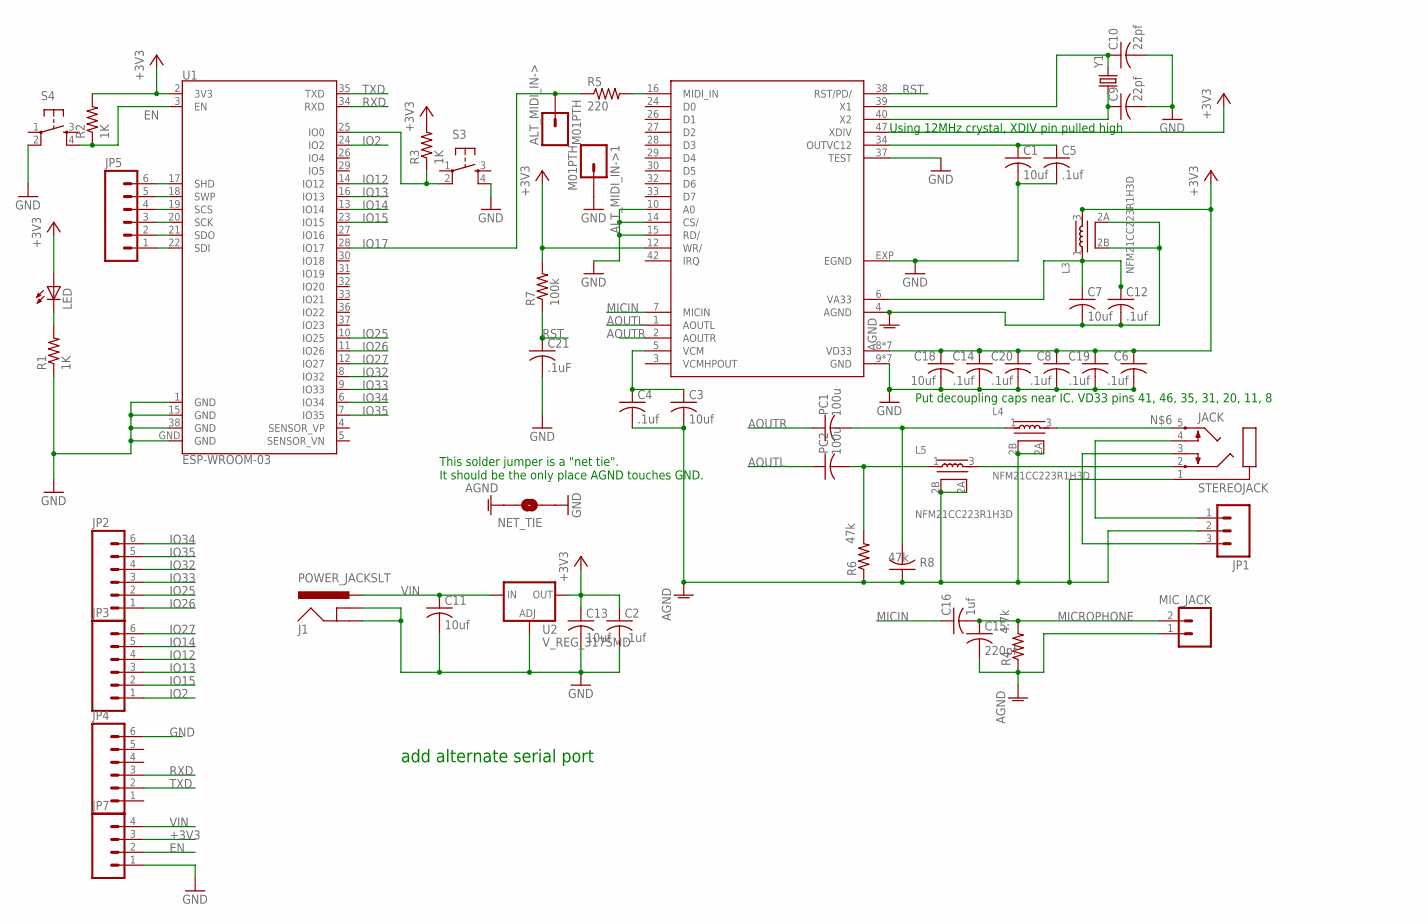
[picture p15: schematic Fluxamasynth32.sch]

Parts:
ALT_MIDI_IN->, ALT_MIDI_IN->1: M01PTH; 1X01
C1, C3, C7: 10uf; C0805K
C2, C4, C5, C6, C8, C12, C14, C19, C20: .1uf; C0603K
C9, C10: 22pf; C0603
C11, C13: 10uf; C1206
C15: 220pf; C0805K
C16: 1uf; C0603K
C18: 10uf; C0603K
C21: .1uF; C0603K
J1: POWER_JACKSLT; POWER_JACK_SLOT
JACK: STEREOJACK; STX3100
JP1: M03PTH; 1X03
JP2, JP3, JP4, JP5: M06NO_SILK; 1X06_NO_SILK
JP7: M041X04_NO_SILK; 1X04_NO_SILK
L3, L4, L5: NFM21CC223R1H3D; 3PC
LED: LED0603; LED-0603
MIC_JACK: M02PTH; 1X02
NET_TIE: MODERNDEVICE_SOLDERJUMPERTRACE; MODERNDEVICE_SJ_2S-TRACE
PC1, PC2: 100u; C1206K
R1, R2, R3: 1K; R0603
R4: 4.7k; R0603
R5: 220; R0603
R6: 47k; R0603
R7: 100k; R0603
R8: 47k; C0603K
S3, S4: 6MM_SWITCH6MM_SWITCH; 6MM_SWITCH
SAM2695: SAM2695; QFN48
U1: ESP-WROOM-03
U2: V_REG_317SMD; SOT223
Y1: CRYSTALTXC-7A; CRYSTAL-TXC-7A

Connections:
+3V3: C2.1, C6.1, C8.1, C13.1, C14.1, C18.1, C19.1, C20.1, JP7.3, L3.3, LED.A, R2.2, R3.2, R7.2, SAM2695.8 (VD33), SAM2695.11 (VD33), SAM2695.12 (WR/), SAM2695.20 (VD33), SAM2695.31 (VD33), SAM2695.35 (VD33), SAM2695.41 (VD33), SAM2695.46 (VD33), SAM2695.47 (XDIV), U1.2 (3V3), U2.2 (OUT), U2.4 (OUT)
AGND: C3.2, C4.2, C7.2, C12.2, C15.2, JACK.1, JP1.2, L3.2A, L3.2B, L4.2A, L4.2B, L5.2A, L5.2B, MIC_JACK.1, NET_TIE.2, R4.1, R6.1, R8.1, SAM2695.4 (AGND)
AOUTL: PC2.1, SAM2695.1 (AOUTL)
AOUTR: PC1.1, SAM2695.2 (AOUTR)
EN: JP7.2, R2.1, S4.4 (S1), U1.3 (EN)
GND: ALT_MIDI_IN->1.1, C1.2, C2.2, C5.2, C6.2, C8.2, C9.2, C10.2, C11.2, C13.2, C14.2, C18.2, C19.2, C20.2, C21.2, J1.GND@1 (GNDBREAK), J1.GND@2 (GND), JP4.6, JP7.1, NET_TIE.1, R1.1, S3.4 (S1), S4.2 (P1), SAM2695.9 (GND), SAM2695.10 (A0), SAM2695.13 (GND), SAM2695.14 (CS/), SAM2695.15 (RD/), SAM2695.18 (GND), SAM2695.25 (GND), SAM2695.36 (GND), SAM2695.37 (TEST), SAM2695.45 (GND), SAM2695.48 (GND), SAM2695.EXP (EGND), U1.1 (GND), U1.15 (GND), U1.38 (GND), U1.GND, U2.1 (ADJ)
IO2: JP3.1, U1.24 (IO2)
IO12: JP3.4, U1.14 (IO12)
IO13: JP3.3, U1.16 (IO13)
IO14: JP3.5, U1.13 (IO14)
IO15: JP3.2, U1.23 (IO15)
IO17: ALT_MIDI_IN->.1, R5.1, U1.28 (IO17)
IO25: JP2.2, U1.10 (IO25)
IO26: JP2.1, U1.11 (IO26)
IO27: JP3.6, U1.12 (IO27)
IO32: JP2.4, U1.8 (IO32)
IO33: JP2.3, U1.9 (IO33)
IO34: JP2.6, U1.6 (IO34)
IO35: JP2.5, U1.7 (IO35)
MICIN: C16.1, SAM2695.7 (MICIN)
MICROPHONE: C15.1, C16.2, MIC_JACK.2, R4.2
unnamed: R3.1, S3.2 (P1), U1.25 (IO0)
unnamed: JP5.1, U1.22 (SDI)
unnamed: L5.1, PC2.2, R6.2
unnamed: JACK.5, L4.3
unnamed: JP5.2, U1.21 (SDO)
unnamed: JP5.3, U1.20 (SCK)
unnamed: LED.C, R1.2
unnamed: JP5.4, U1.19 (SCS)
unnamed: JP5.5, U1.18 (SWP)
unnamed: R5.2, SAM2695.16 (MIDI_IN)
unnamed: JP5.6, U1.17 (SHD)
unnamed: JACK.4, JP1.1
unnamed: JACK.3, JP1.3
OUTVC12: C1.1, C5.1, SAM2695.34 (OUTVC12)
OUT_L: JACK.2, L5.3
OUT_R: L4.1, PC1.2, R8.2
RST: C21.1, R7.1, SAM2695.38 (RST/PD/)
RXD: JP4.3, U1.34 (RXD)
TXD: JP4.2, U1.35 (TXD)
VA33: C7.1, C12.1, L3.1, SAM2695.6 (VA33)
VCM: C3.1, C4.1, SAM2695.5 (VCM)
VIN: C11.1, J1.PWR, JP7.4, U2.3 (IN)
XTL1: C10.1, SAM2695.39 (X1), Y1.P$2 (2)
XTL2: C9.1, SAM2695.40 (X2), Y1.P$1 (1)

Notes on the sheet:
Using 12MHz crystal, XDIV pin pulled high
Put decoupling caps near IC. VD33 pins 41, 46, 35, 31, 20, 11, 8
This solder jumper is a "net tie". It should be the only place AGND touches GND.
add alternate serial port

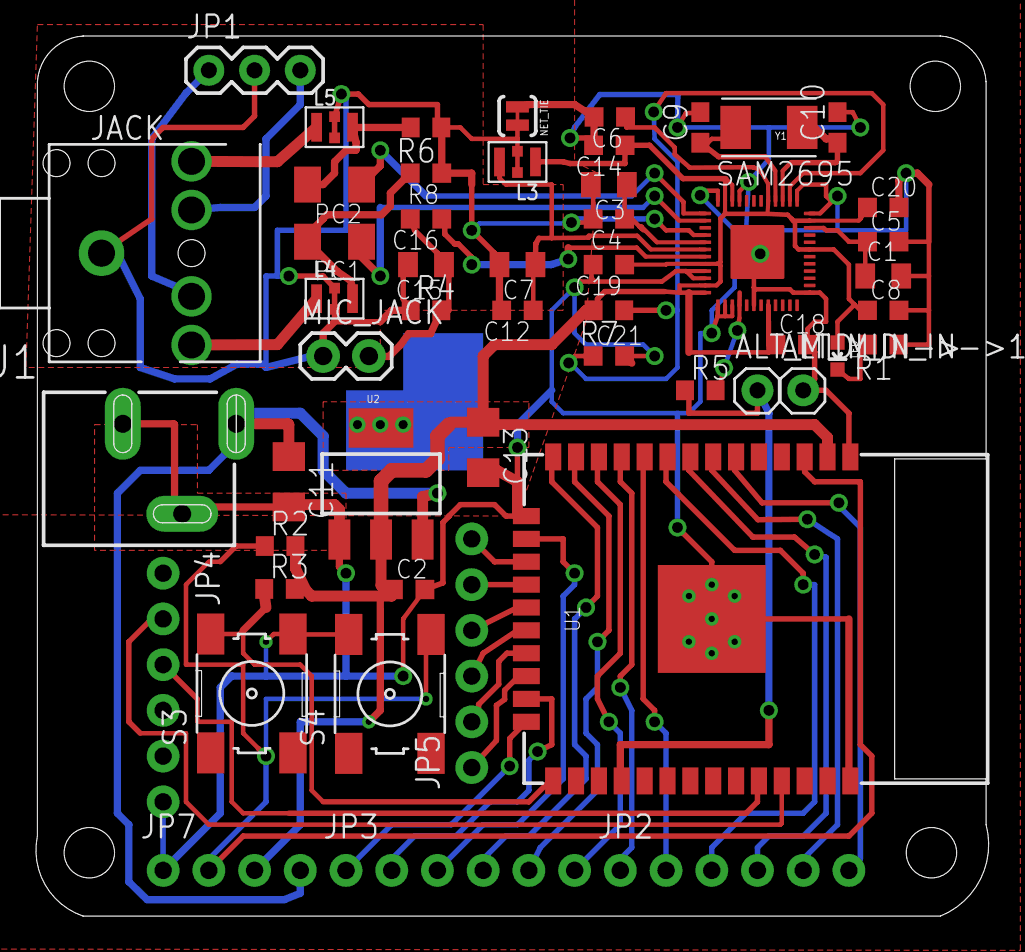
[picture p16: board Fluxamasynth32.brd from above]

Board: 2 copper layers, 52.9 x 48.9 mm, 52 parts (0 on the bottom side), 45 nets.
