fluxly/Fluxamasynth-Designs/Fluxamasynth_III/dream_breakout/dream_breakout.brd

## EAGLE design Fluxamasynth_III/dream_breakout/dream_breakout.brd (2018-05-23)

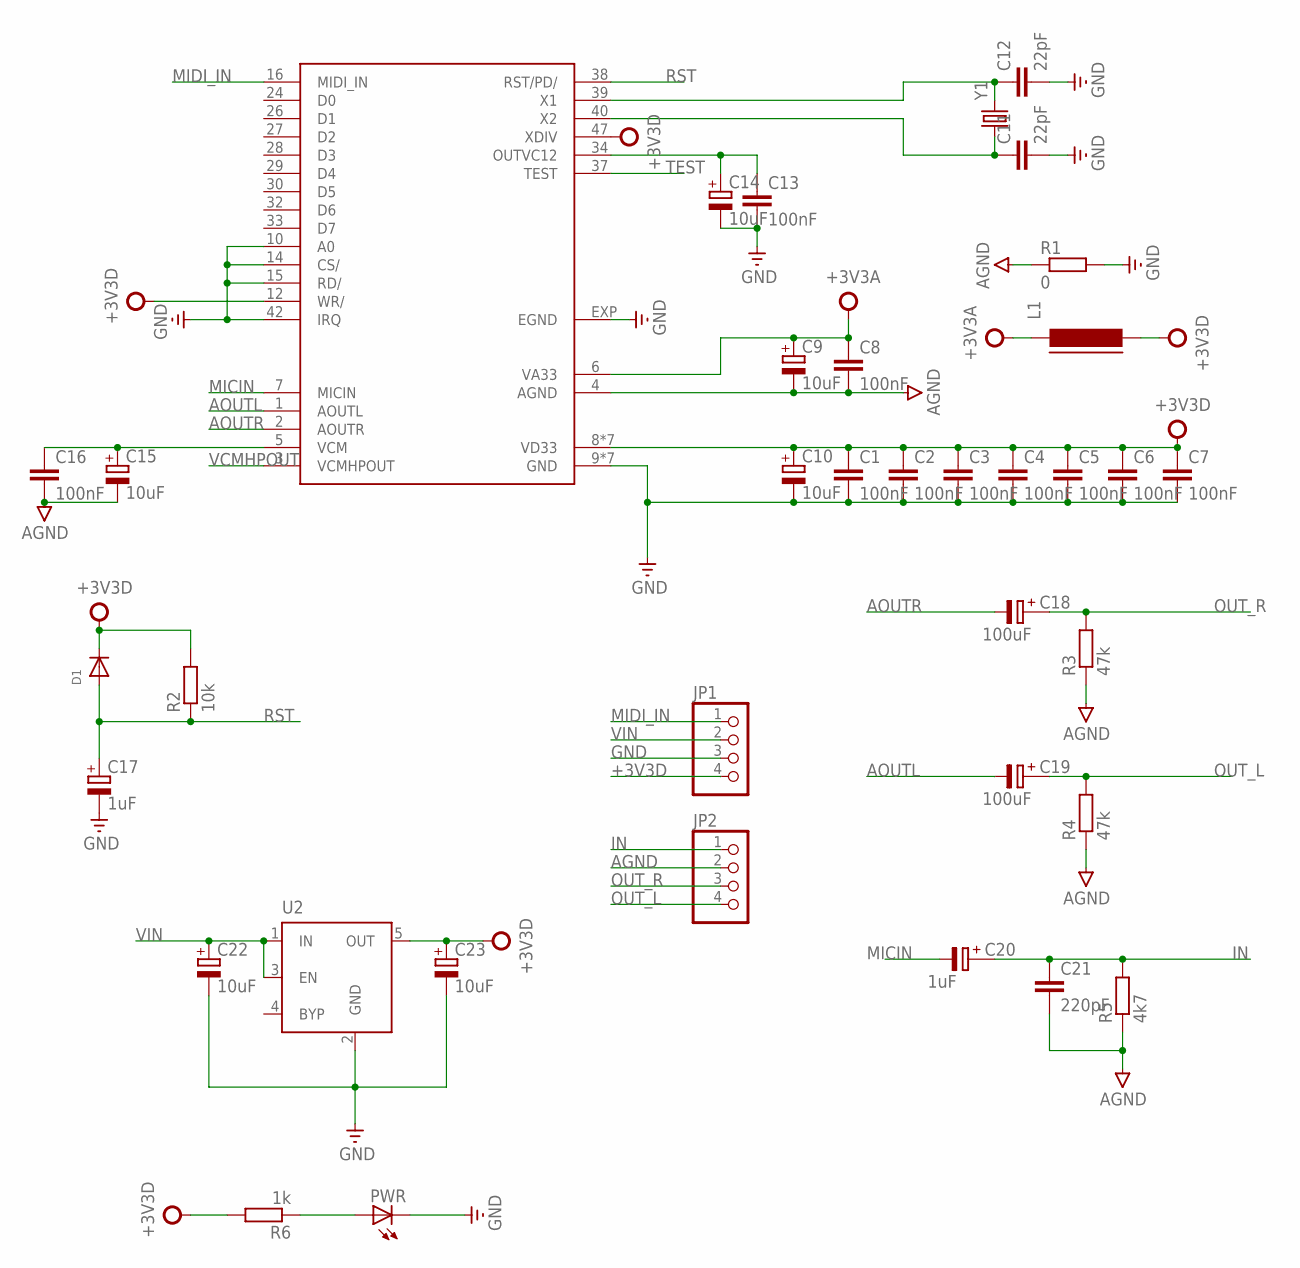
[picture p17: schematic dream_breakout.sch]

Parts:
C1, C2, C3, C4, C5, C6, C7, C8, C13, C16: 100nF; C0603K
C9, C10, C14, C15, C22, C23: 10uF; A/3216-18R
C11, C12: 22pF; C0603K
C17: 1uF; A/3216-18R
C18, C19: 100uF; SV-B
C20: 1uF; SV-B
C21: 220pF; C0603K
D1: DIODESOD-123; SOD-123
JP1, JP2: HEADER-1X4ROUND; 1X04_ROUND
L1: FERRITE-0603; FB603
PWR: LEDCHIP-LED0603; CHIP-LED0603
R1: 0; R0603
R2: 10k; R0603
R3, R4: 47k; R0603
R5: 4k7; R0603
R6: 1k; R0603
U1: SAM2695; QFN48
U2: MIC5219XX; SOT23-5
Y1: CRYSTALTXC-7A; CRYSTAL-TXC-7A

Connections:
+3V3A: C8.1, C9.+, L1.1, U1.6 (VA33)
+3V3D: C1.1, C2.1, C3.1, C4.1, C5.1, C6.1, C7.1, C10.+, C23.+, D1.C, JP1.4, L1.2, R2.2, R6.2, U1.8 (VD33), U1.11 (VD33), U1.12 (WR/), U1.20 (VD33), U1.31 (VD33), U1.35 (VD33), U1.41 (VD33), U1.46 (VD33), U1.47 (XDIV), U2.5 (OUT)
AGND: C8.2, C9.-, C15.-, C16.2, C21.2, JP2.2, R1.1, R3.1, R4.1, R5.1, U1.4 (AGND)
AOUTL: C19.-, U1.1 (AOUTL)
AOUTR: C18.-, U1.2 (AOUTR)
GND: C1.2, C2.2, C3.2, C4.2, C5.2, C6.2, C7.2, C10.-, C11.2, C12.2, C13.2, C14.-, C17.-, C22.-, C23.-, JP1.3, PWR.C, R1.2, U1.9 (GND), U1.10 (A0), U1.13 (GND), U1.14 (CS/), U1.15 (RD/), U1.18 (GND), U1.25 (GND), U1.36 (GND), U1.42 (IRQ), U1.45 (GND), U1.48 (GND), U1.EXP (EGND), U2.2 (GND)
IN: C20.+, C21.1, JP2.1, R5.2
MICIN: C20.-, U1.7 (MICIN)
MIDI_IN: JP1.1, U1.16 (MIDI_IN)
unnamed: C13.1, C14.+, U1.34 (OUTVC12)
unnamed: C12.1, U1.39 (X1), Y1.P$2 (2)
unnamed: C11.1, U1.40 (X2), Y1.P$1 (1)
unnamed: PWR.A, R6.1
unnamed: C15.+, C16.1, U1.5 (VCM)
OUT_L: C19.+, JP2.4, R4.2
OUT_R: C18.+, JP2.3, R3.2
RST: C17.+, D1.A, R2.1, U1.38 (RST/PD/)
TEST: U1.37 (TEST)
VCMHPOUT: U1.3 (VCMHPOUT)
VIN: C22.+, JP1.2, U2.1 (IN), U2.3 (EN)

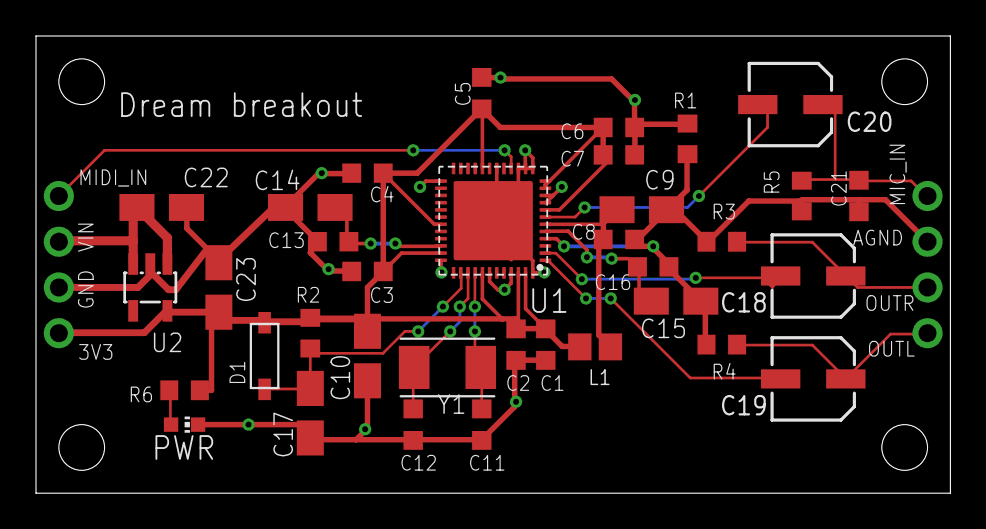
[picture p18: board dream_breakout.brd from above]

Board: 2 copper layers, 50.8 x 25.4 mm, 38 parts (1 on the bottom side), 18 nets.

Other parts of the board:
U$1: PANDA
