fluxly/Fluxamasynth-Designs/Fluxamasynth_III/flux2_a1.brd

## EAGLE design Fluxamasynth_III/flux2_a1.brd (2018-05-23)

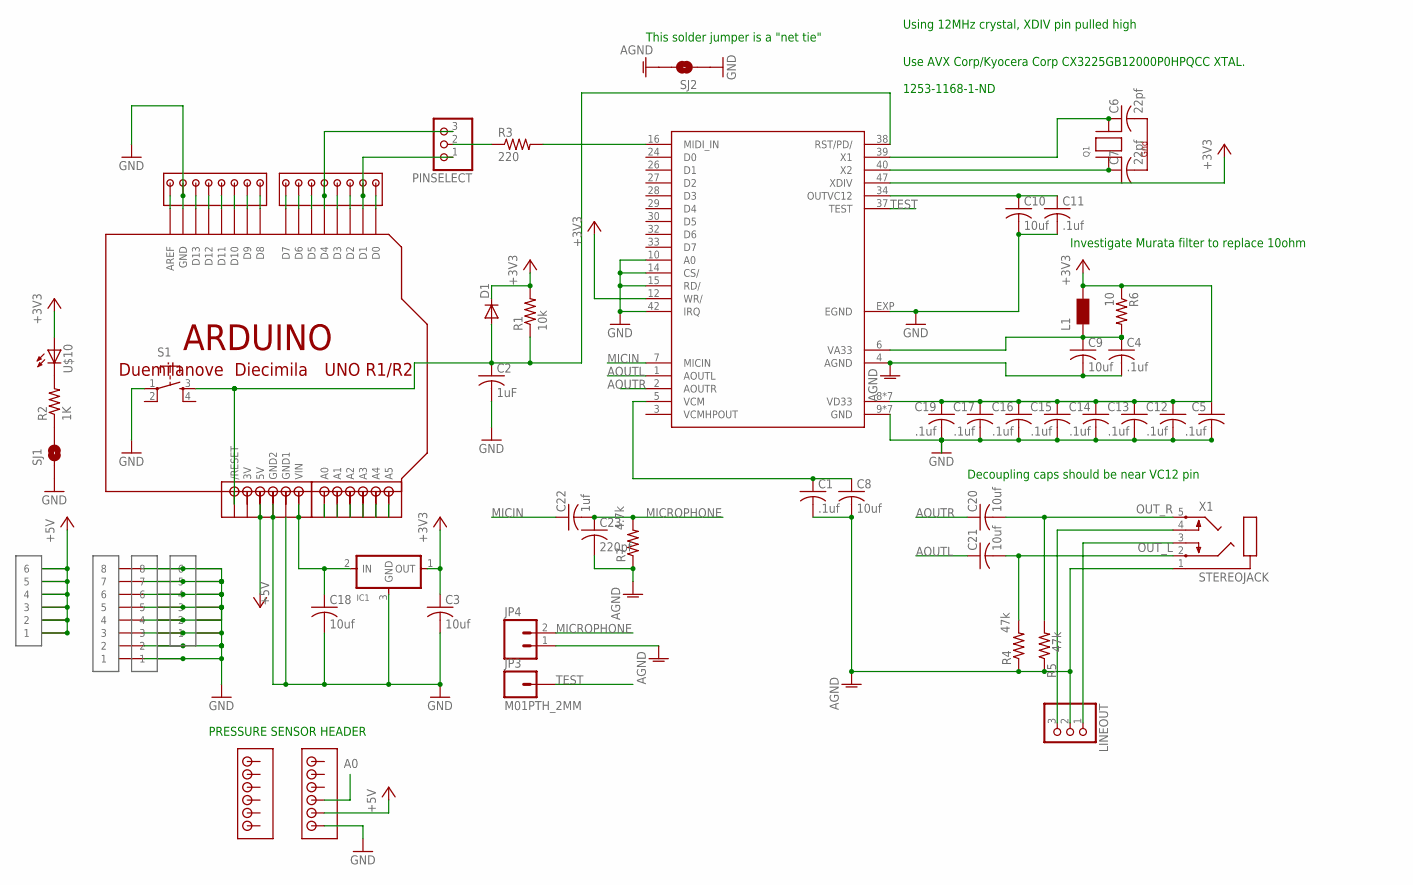
[picture p19: schematic flux2_a1.sch]

Parts:
C1, C4, C5, C11, C12, C13, C14, C15, C16, C17, C19: .1uf; C0805
C2: 1uF; C0805
C3, C8, C9, C10, C18, C20, C21: 10uf; C0805
C6, C7: 22pf; C0805
C22: 1uf; C0805
C23: 220pf; C0805
D1: DIODESOD123; SOD123
IC1: REGULATORSOT23; SOT23
JP3: M01PTH_2MM; 1X01_2MM
JP4: M02PTH; 1X02
L1: FERRITE_BEAD_L0603; R0603
LINEOUT: PINHD-1X3; 1X03
PINSELECT: PINHD-1X3; 1X03
Q1: MODERNDEVICE_XTAL-4-3225; MODERNDEVICE_NX3225
R1: 10k; M0805
R2: 1K; M0805
R3: 220; M0805
R4, R5: 47k; M0805
R6: 10; M0805
R7: 4.7k; M0805
S1: 6MM_SWITCH6MM_SWITCH; 6MM_SWITCH
SJ1, SJ2: MODERNDEVICE_SOLDERJUMPERTRACE; MODERNDEVICE_SJ_2S-TRACE
U1: SAM2695; QFN48
U$1, U$11: 1X8_CLEAN
U$2, U$3: 1X6_CLEAN
U$4, U$5, U$7, U$8: 1X6HEADER
U$6, U$9: 1X8HEADER
U$10: LED1206; 1206
U$12: ARDUINO-NOHOLE
X1: STEREOJACK; STX3100

Connections:
3V: U$12.3V
+3V3: C3.1, D1.CATHODE (C), IC1.1 (OUT), L1.2, R1.2, R6.1, U1.12 (WR/), U1.47 (XDIV), U$10.1 (A)
+5V: U$2.P$1 (1), U$2.P$2 (2), U$2.P$3 (3), U$2.P$4 (4), U$2.P$5 (5), U$2.P$6 (6), U$7.P$2, U$8.P$3, U$12.5V
A0: U$5.P$1, U$7.P$3, U$12.A0
AGND: C1.2, C4.2, C8.2, C9.2, C23.2, JP4.1, LINEOUT.2, R4.1, R5.1, R7.1, SJ2.2, U1.4 (AGND), X1.1
AOUTL: C21.1, U1.1 (AOUTL)
AOUTR: C20.1, U1.2 (AOUTR)
GND: C2.2, C3.2, C5.2, C10.2, C11.2, C12.2, C13.2, C14.2, C15.2, C16.2, C17.2, C18.2, C19.2, IC1.3 (GND), S1.1, SJ1.1, SJ2.1, U1.9 (GND), U1.10 (A0), U1.13 (GND), U1.14 (CS/), U1.15 (RD/), U1.18 (GND), U1.25 (GND), U1.36 (GND), U1.42 (IRQ), U1.45 (GND), U1.48 (GND), U1.EXP (EGND), U$1.P$1 (1), U$1.P$2 (2), U$1.P$3 (3), U$1.P$4 (4), U$1.P$5 (5), U$1.P$6 (6), U$1.P$7 (7), U$1.P$8 (8), U$3.P$1 (1), U$3.P$2 (2), U$3.P$3 (3), U$3.P$4 (4), U$3.P$5 (5), U$3.P$6 (6), U$7.P$1, U$8.P$4, U$9.P$2, U$11.P$1 (1), U$11.P$2 (2), U$11.P$3 (3), U$11.P$4 (4), U$11.P$5 (5), U$11.P$6 (6), U$11.P$7 (7), U$11.P$8 (8), U$12.GND, U$12.GND1, U$12.GND2
MICIN: C22.1, U1.7 (MICIN)
MICROPHONE: C22.2, C23.1, JP4.2, R7.2
unnamed: PINSELECT.2, R3.1
unnamed: R3.2, U1.16 (MIDI_IN)
unnamed: C5.1, C12.1, C13.1, C14.1, C15.1, C16.1, C17.1, C19.1, U1.8 (VD33), U1.11 (VD33), U1.20 (VD33), U1.31 (VD33), U1.35 (VD33), U1.41 (VD33), U1.46 (VD33)
unnamed: C10.1, C11.1, U1.34 (OUTVC12)
unnamed: R2.2, U$10.2 (C)
unnamed: C1.1, C8.1, U1.5 (VCM)
unnamed: U$9.P$8, U$12.D8
unnamed: PINSELECT.1, U$6.P$7, U$12.D1
unnamed: PINSELECT.3, U$6.P$4, U$12.D4
unnamed: U$9.P$7, U$12.D9
unnamed: LINEOUT.3, X1.4
unnamed: U$9.P$5, U$12.D11
unnamed: U$9.P$6, U$12.D10
unnamed: LINEOUT.1, X1.3
unnamed: U$9.P$4, U$12.D12
unnamed: U$9.P$3, U$12.D13
unnamed: U$6.P$2, U$12.D6
unnamed: U$9.P$1, U$12.AREF
unnamed: U$6.P$3, U$12.D5
unnamed: U$6.P$8, U$12.D0
unnamed: U$6.P$6, U$12.D2
unnamed: U$6.P$5, U$12.D3
unnamed: U$6.P$1, U$12.D7
unnamed: C2.1, D1.ANODE (A), R1.1, S1.3 (S), U1.38 (RST/PD/), U$8.P$1
unnamed: C4.1, C9.1, L1.1, R6.2, U1.6 (VA33)
unnamed: U$5.P$2, U$12.A1
unnamed: U$5.P$3, U$12.A2
unnamed: U$5.P$4, U$12.A3
unnamed: U$5.P$5, U$12.A4
unnamed: U$5.P$6, U$12.A5
unnamed: R2.1, SJ1.2
unnamed: C6.1, Q1.3 (X2), U1.39 (X1)
unnamed: C7.1, Q1.1 (X1), U1.40 (X2)
unnamed: C6.2, Q1.2 (G2)
unnamed: C7.2, Q1.4 (G1)
OUT_L: C21.2, R4.2, X1.2
OUT_R: C20.2, R5.2, X1.5
TEST: JP3.1, U1.37 (TEST)
VIN: C18.1, IC1.2 (IN), U$8.P$6, U$12.VIN

Notes on the sheet:
PRESSURE SENSOR HEADER
Using 12MHz crystal, XDIV pin pulled high
Investigate Murata filter to replace 10ohm
Use AVX Corp/Kyocera Corp CX3225GB12000P0HPQCC XTAL. 1253-1168-1-ND
Decoupling caps should be near VC12 pin
This solder jumper is a "net tie"

Board: 2 copper layers, 55 parts (0 on the bottom side), 48 nets, no tracks yet.
