fluxly/Fluxamasynth-Designs/(commit log)

2018-02-06 add design files
    [Fluxamasynth32.brd, Fluxamasynth32.sch, FluxamasynthFeather.brd, FluxamasynthFeather.sch, FluxamasynthPi.brd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]
2018-05-23 Feather, Pi updates
    [FluxR3-rev0-lessdecoupling.brd, FluxR3-rev0-lessdecoupling.sch, FluxR3-rev1.brd, FluxR3-rev1.sch, FluxR3-v1.brd, FluxR3-v1.sch, FluxR3-v2.brd, FluxR3-v2.sch]
