fluxly/Fluxamasynth-Designs/(notices)

Notices in the files:
parts and their libraries:
SparkFun-FreqCtrl: Licensing: CC v3.0 Share-Alike You are welcome to use this library for commercial purposes.
SparkFun-FreqCtrl: Licensing: Creative Commons ShareAlike 4.0 International - https://creativecommons.org/licenses/by-sa/4.0
cap-pan40: Copyright (C) 2004, Bob Starr
